Gyuuu3/IOT_Project/stm_actuator/Doc/log.md

2026.7.17

————————————————————————————————————————————————

keil5创建项目显示无法识别芯片

用于stm32f103，

解决：options for target->c/c++->define 修改

空->USE\_HAL\_DRIVER,STM32F103xB

————————————————————————————————————————————————

烧录时弹出No Algorithm found for: 08000000H - 08001CB3H

Erase skipped!

警告
解决：options for targets ->debug-> settings->flash download->选中description 修改size 0x000200000->0x000100000

—————————————————————————————————————————————————显示无法烧录

Error: Flash Download failed  -  Target DLL has been cancelled

原因：烧录时freertos处于低功耗任务，烧录线被占用
MCU在运行程序时阻止了调试接口（可能是SWD被禁用，或者程序进入了低功耗模式或跑飞）。按复位键能让MCU停止运行，此时烧录器可以连接。松开复位键程序运行，但烧录过程需要程序不运行才能擦写

解决：长按板复位键并烧录

\########################################################################################################################################################################################################################

2026.7.18

—————————————————————————————————————————————————

串口发送必须加 FreeRTOS 互斥锁，多任务同时调用打印一定会出现文字错乱，这是嵌入式 RTOS 串口通用踩坑点。

—————————————————————————————————————————————————

发现freertos任务卡死，以及烧录无法正常运行

原因：移植了FreeRTOS的stm32f1xx\_it.c文件中void SysTick\_Handler(void)函数未加入
if(xTaskGetSchedulerState()!=taskSCHEDULER\_NOT\_STARTED){

&#x09; xPortSysTickHandler();

&#x20; }
即未开启SysTick定时器中断

—————————————————————————————————————————————————QUEST发现串口打印问题==部分任务"\\r\\n"无法正常换行打印==

\##########################################################################################################################################################################

2026.7.24

—————————————————————————————————————————————————STM32与ESP32串口通信异常

问题：

ESP32通过UART向STM32发送数据帧 \[0xAA]\[CMD]\[0xBB]

STM32端每次仅收到1个字节（`0xAA`），后续字节丢失，无法解析完整指令

原因：

串口接收方式不合理

ESP\_UART\_Recv()采用非阻塞轮询方式读取UART数据，每次仅读取当前FIFO中已到达的字节，不等待后续数据。ESP32发送的3字节帧在时间上有微小间隔，导致STM32三次轮询各读到1个字节，每次都不完整。

解决：

启用UART空闲中断 + DMA接收

在 usart.c中配置：

\- DMA循环接收模式

\- UART空闲中断（IDLE interrupt）

\- 中断回调中获取数据长度并置位帧就绪标志

任务层状态机解析

vESPTask中增加帧接收状态机，支持完整帧的检测与解析，避免拆包问题。
