Gyuuu3/IOT_Project/esp32_template/Doc/原理图.pdf

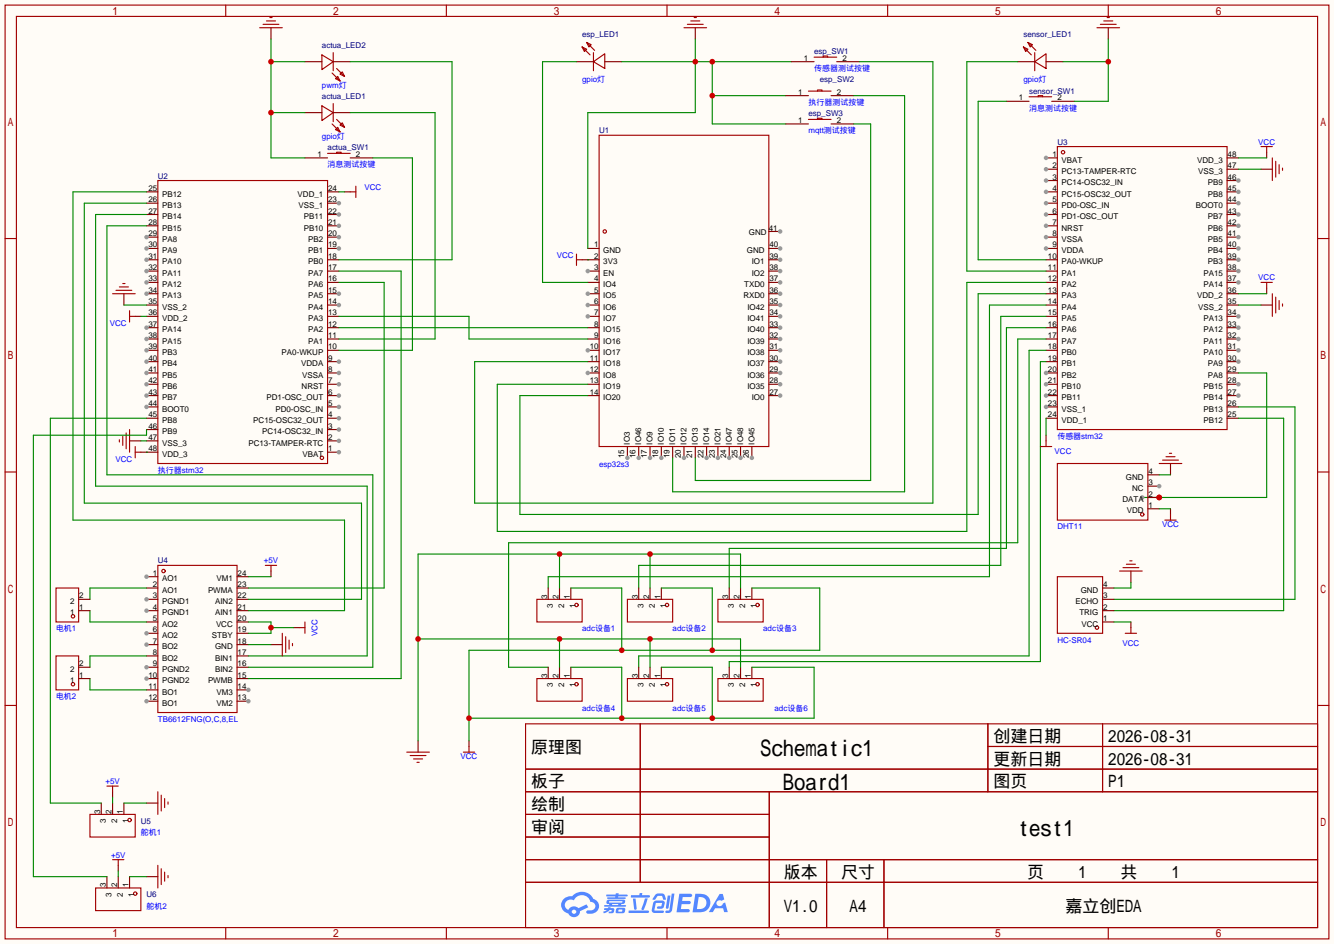
[picture p1: page 1]

原理图 | Schematic1 | 创建日期 | 2026-08-31

更新日期 | 2026-08-31

板子 | Board1 | 图页 | P1
绘制 | | test1
审阅

V1.0 | A4 | 嘉立创EDA
