Gyuuu3/IOT_Project/stm_actuator/cubemx_gen/Core/Inc/main.h

#define KEY1_Pin GPIO_PIN_0
#define KEY1_GPIO_Port GPIOA
#define LED1_Pin GPIO_PIN_1
#define LED1_GPIO_Port GPIOA
#define MOTOR1_Pin GPIO_PIN_6
#define MOTOR1_GPIO_Port GPIOA
#define MOTOR2_Pin GPIO_PIN_7
#define MOTOR2_GPIO_Port GPIOA
#define LED2_Pin GPIO_PIN_0
#define LED2_GPIO_Port GPIOB
#define MOTOR1_IN1_Pin GPIO_PIN_12
#define MOTOR1_IN1_GPIO_Port GPIOB
#define MOTOR1_IN2_Pin GPIO_PIN_13
#define MOTOR1_IN2_GPIO_Port GPIOB
#define MOTOR2_IN1_Pin GPIO_PIN_14
#define MOTOR2_IN1_GPIO_Port GPIOB
#define MOTOR2_IN2_Pin GPIO_PIN_15
#define MOTOR2_IN2_GPIO_Port GPIOB
#define SERVO1_Pin GPIO_PIN_8
#define SERVO1_GPIO_Port GPIOB
#define SERVO2_Pin GPIO_PIN_9
#define SERVO2_GPIO_Port GPIOB
