Gyuuu3/IOT_Project/(notices)

Notices in the files:
stm_actuator/cubemx_gen/Core/Src/usart.c:
Copyright (c) 2026 STMicroelectronics.
All rights reserved.
This software is licensed under terms that can be found in the LICENSE file
